holgero/XFD/hardware/xfd_proto.jpg

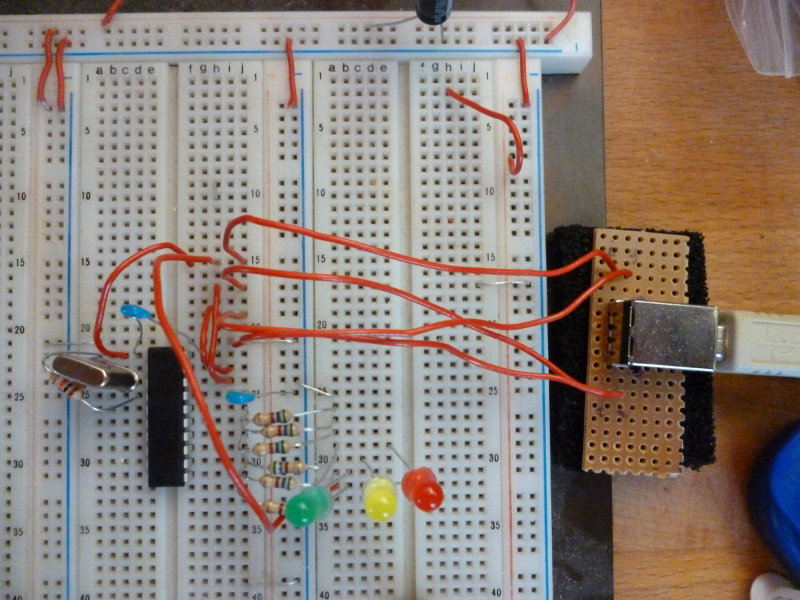
hardware/xfd_proto.jpg
