holgero/XFD/hardware/xfd_traffic.jpg

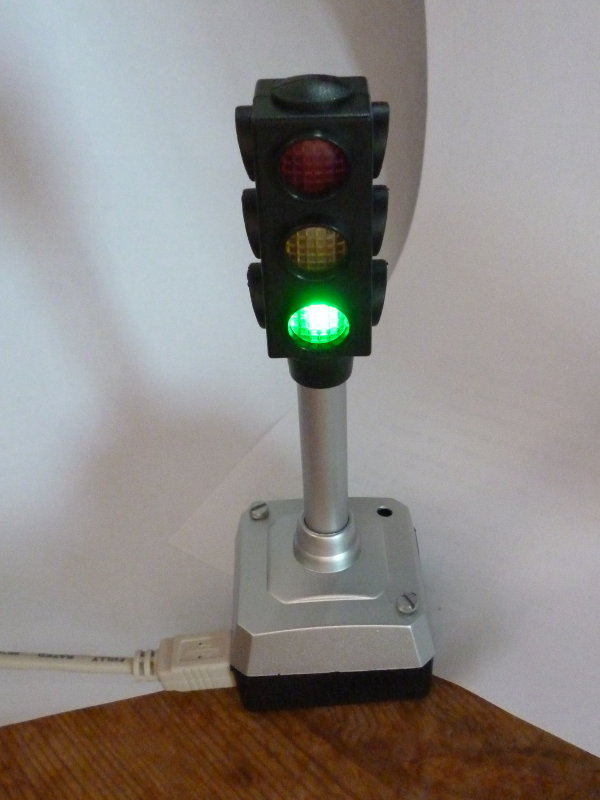
hardware/xfd_traffic.jpg
