holgero/XFD/hardware/XFD.jpeg

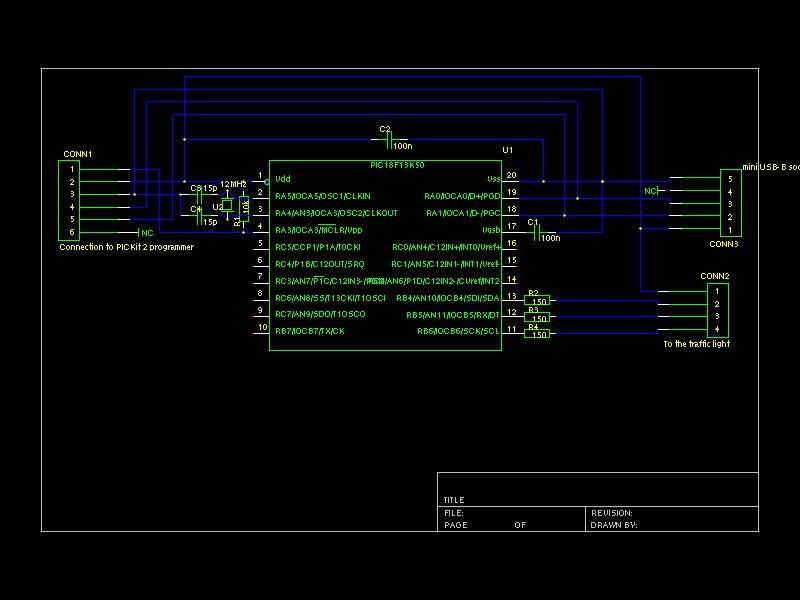
hardware/XFD.jpeg
