holgero/XFD/(list of files, drawings)

Other design files:
hardware/XFD.pcb
