holgero/XFD/java/usbleds/src/main/java/de/holger_oehm/usb/leds/DyiLeds.java

/*
 *  Copyright (C) 2012 Holger Oehm
 *
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
 *  You should have received a copy of the GNU General Public License
 *  along with this program.  If not, see <http://www.gnu.org/licenses/>.
 */

package de.holger_oehm.usb.leds;

import de.holger_oehm.usb.device.SimpleUSBDevice;

public final class DyiLeds extends AbstractLeds {

    public DyiLeds(final SimpleUSBDevice device) {
        super(device);
    }

    @Override
    public void red() {
        setReportData(1, 0, 0, 0, 0);
    }

    @Override
    public void off() {
        setReportData(0, 0, 0, 0, 0);
    }

    @Override
    public void yellow() {
        setReportData(0, 1, 0, 0, 0);
    }

    @Override
    public void green() {
        setReportData(0, 0, 1, 0, 0);
    }

    @Override
    public void blue() {
        setReportData(0, 0, 0, 1, 0);
    }

    @Override
    public void white() {
        setReportData(0, 0, 0, 0, 1);
    }

    @Override
    public void magenta() {
        setReportData(1, 0, 0, 1, 0);
    }

    @Override
    public void cyan() {
        setReportData(0, 1, 0, 1, 0);
    }

    public void flash() {
        setReportData(0, 0, 0, 0, 0, 0, 0, 0x042);
    }

    @Override
    public void set(final LedColor... colors) {
        int red = 0, yellow = 0, green = 0, blue = 0, white = 0;
        for (final LedColor ledColor : colors) {
            switch (ledColor) {
            case RED:
                red = 1;
                break;
            case YELLOW:
                yellow = 1;
                break;
            case GREEN:
                green = 1;
                break;
            case BLUE:
                blue = 1;
                break;
            case WHITE:
                white = 1;
                break;
            case CYAN:
                green = 1;
                blue = 1;
                break;
            case MAGENTA:
                blue = 1;
                red = 1;
                break;
            default:
                throw new IllegalStateException("Unexpected color " + ledColor);
            }
        }
        setReportData(red, yellow, green, blue, white);
    }
}
