holgero/XFD/(commit log)

2012-06-30 Move back a step and match USBDemo more closely
    Works on USB port with RB4 as a keyboard on/off
    switch.
    Glitches: continues to send the last key over
    and over...
    [main.asm]
2012-06-30 fixed todos, still works
    [main.asm]
2012-06-30 Fixed glitch (repeating last key when off)
    [main.asm]
2012-06-30 light LED on RA1
    if the first byte of incoming data has its bit 1 set, set
    RA1 to high.
2012-07-01 structure usb, changed PID
    * extracted routines in usb.asm for documentation
    * changed PID to 0xFF0c (arbitrary value)
    * changed device name string
2012-07-01 adapted to new purpose: switch three LEDs
2012-07-01 3 LEDs on RB0,1,2
    protocol changed: first three bytes are now the LED_state
    first byte, bit 0: red led
    second byte, bit 0: yellow led
    third byte, bit 0: green led
2012-07-01 renamed lamp to leds
2012-07-01 understand usb driver+updated readme
2012-07-01 fixed usb hid report descriptor
    now report as 3 leds, not a keyboard
2012-07-01 report current state of leds
2012-07-02 added two more leds (blue and white)
2012-07-02 added led chaser script
2012-07-02 changed HID report: use collection around leds
2012-07-02 Fixed HID data (added new LEDs)
2012-07-07 all LEDs off on start and fewer select macros
2012-07-07 removed last select macro
    and also case, break, ends, default and the
    complete include file ENGR2210.inc
2012-07-08 added java project
    Can change the state of the LEDs of the own craftet version
    and the dream cheeky compatible version.
    Uses HID.DLL over JNA on windows and libusblib.so over JNA
    on linux.
2012-07-08 magenta leds for exceptions in monitor loop
2012-07-08 switch off leds at termination
    added shutdown hook, to make sure the LEDs.close() will be
    called.
    removed throws IOException from close() methods.
2012-07-08 let usbleds.factory enumerate connected led devices
    instead of having every client try to find one.
    clients should no longer know the usb adresses of led devices
    [BuildMonitor.java]
2012-07-13 connected traffic light module
    three more io pins to switch RA0:red, RA1:yellow, RA2:green.
    Logic of pins is inverted: 0: LED is lit, 1: off.
    [main.asm]
2012-07-16 Light yellow led in state BUILDING.
2012-07-18 blink yellow if the host does not talk to the device
2012-07-23 adaption to pic18f13k50
    DOES NOT WORK YET.
    [main.asm]
2012-07-25 prepare push to github
    * extract vid:pid to toplevel makefile
    * add README
2012-07-28 Added a picture of prototype hardware
2012-07-28 added schematics
    [XFD.sch]
2012-07-28 Schematics and picture for pic18f13k50
    [XFD.sch]
2012-07-29 cleaned up Makefiles
    * make sure we allways run a clean build
    * test if VID and PID are specified in toplevel Makefile
2012-07-29 cleaned up folder structure
    merged contents of "doc" and "schematic" into new folder "hardware"
    [XFD.sch]
2012-07-29 Moved symbol pic18f13k50-1.sym to local dir
    [XFD.sch]
2012-07-30 started layout
    the layout should be complete but the footprint of the USB connector
    may be completely wrong... Be warned: I did not use this layout yet.
    [XFD.pcb, XFD.sch]
2012-07-30 changed footprint of USB connector
    [XFD.pcb, XFD.sch]
2012-07-31 fixed USB-B footprint
    [XFD.pcb]
2012-08-05 created Bill of Materials
2012-08-06 use USBIF interrupt
    * configure interrupts to use priorities
    * make usb interrupt low prio, switch off all other interrupts
    * dispatch to ServiceUSB when USB interrupt occurs
    * save registers on interrupts
2012-08-07 changed device class to vendor specific
    removed report descriptor, hid descriptor and changed
    manufactor to my name, added branch description to README
2012-08-11 implemented suspend state
    SLEEP when the bus becomes idle (IDLEIF) and resume when there is
    some action (ACTVIF).
    Also fixed comments on timing (wait time of timer1 is correct
    with 10 ms, but most comments around blinkenlights were wrong).
    [main.asm]
2012-08-12 added footprint for miniUSB-B receptable
2012-08-12 use mini USB-B socket in layout
    [XFD.pcb, XFD.sch]
2012-08-13 second configuration with 500 mA max current
2012-09-09 fixed headers: only one license
    also added a clean target to toplevel makefile
    and updated firmware submodule version
    [descriptor.asm, vectors_nobootloader.asm]
2012-10-30 bugfix: handle build state aborted
    aborted caused an IllegalStateException, now it sets the traffic
    light to yellow
    [BuildMonitor.java]
2012-10-30 handle "currently building" states
    previously: one building state -> yellow led
    now: red_anime -> FAILED_BUILDING -> red + yellow
    green_anime -> OK_BUILDING -> green + yellow
    added method to set multiple LEDs, change makes sense only for the
    DYILeds, DreamCheeky will display color addition, so both
    FAILED_BUILDING and OK_BUILDING will display yellow (not tested).
    [BuildMonitor.java, DreamCheekyLeds.java, DyiLeds.java]
2012-11-04 inverted HW pin configuration
    Now the logic is NOT inverted per default, i.e. a value of one
    for a LED in the usb command sets the corresponding pin to a high
    value per default.
    The old behavior can be achieved by defining INVERTED_IO.
    [main.asm]
2012-11-16 fixed inverted leds during sleep
    [main.asm]
2013-02-11 fixed dream cheeky leds
    [DreamCheekyLeds.java]
2013-03-20 Fix "grey" job state causes IllegalStateException
    Bug: https://github.com/holgero/XFD/issues/1
    [BuildMonitor.java]
2013-06-02 notice if there is no longer an USB device present and ...
    try to recover from the error. No longer ignores the return value when
    sending control messages to USB devices.
    Tries now to reopen the USB device if it had an error. Basic scenario
    where recovery should work is unplugging and plugging the device again.
    [BuildMonitor.java, DyiLeds.java]
2013-06-09 cover the case when the leds are not available during the start
